niztg/Sky130-SAR-ADC/documentation/sar_adc_design.pdf

# 10-bit SAR ADC Design in Sky130 – Project Report

## Contents

1 Introduction and Specifications | 3
2 Architecture Overview | 4
3 Block Design and Sizing | 5
4 Integration & Debugging | 15
5 Static Performance Characterisation | 20

6 Discussion | 23
7 Conclusions | 25
References | 25
A Source Code and Reproducibility | 26

## 1 Introduction and Specifications

The successive-approximation (SAR) ADC is one of the most widely-used and versatile analog-to-digital converter toplogies [1]. Owing to its low power consumption, low la-

tency and compact form factor, it has proven supremely versatile, with notable usage in IoT devices, medical equipment and microcontrollers. This document describes an original 10-bit SAR ADC designed and verified in the SkyWater Sky130 open-source 130nm process, a CMOS PDK developed by SkyWater Technology and Google that provides full device model access without an NDA. The design targets the specifications in Table 1 and covers the complete front-end flow: behavioral modeling from first principles, transistor-level schematic capture in xschem, ngspice simulation against Sky130 device models, and Verilog RTL synthesized to Sky130 standard cells via Yosys. Physical layout is out of scope; the project targets schematic-level verification.

Table 1: Design Specifications

Parameter | Value
Resolution | 10 bits
Sample Rate | 1 MS/s
ENOB | ≥ 9 bits
Supply Voltage, VDD | 1.8 V
Reference Voltage, Vref | 1.8 V
Input Range | 0 − 1.8 V
Process | SkyWater Sky130, 130nm

The design followed a bottom-up flow, progressing sequentially through each of the following stages:

1. First-principles sizing and yield analysis via Python behavioral model
2. Block-level schematic capture in xschem and isolation verification in ngspice
3. Verilog RTL synthesis to Sky130 standard cells via Yosys
4. Full-ADC SPICE integration and static performance characterisation

This document reports the design decisions, block-level verification, integration debugging and static characterisation of the 10-bit SAR ADC. Ultimately, the design achieves a static ENOB of 7.27 bits, falling short of its 9-bit target, attributable to a characterised top-plate feedthrough mechanism detailed in Section 4.

## 2 Architecture Overview

### 2.1 Algorithm Description

The binary code corresponding to Vin is resolved bit-by-bit from MSB to LSB. Each bit N contributes a weighted voltage Vref
2

10−N to a running trial voltage Vanalog; once all bits are settled, Vanalog =

W
1024Vref, where W is the sum of the retained bit weights. At each step, the trial bit is kept if its inclusion keeps Vanalog ≤ Vin, and discarded otherwise. The

process repeats until all 10 bits are resolved.
Using an example voltage of 1.30 V, the behavior of the algorithm can be traced through as follows:
1. Assert bit 9 of the trial code, corresponding to an analog voltage of Vanalog =
| 1
| 2 10−9 ·

Vref = 0.9 V

2. Compare Vin = 1.3 V to Vanalog; Vin > Vanalog, therefore retain bit 9, assert bit 8. New trial code: 1100000000, corresponding voltage Vanalog =
| 1
| 2 10−9 ·Vref +
| 1
| 2 10−8 ·Vref =

1.35 V

3. Compare Vin to Vanalog; Vin < Vanalog therefore reject bit 8, assert bit 7. New code = 1010000000, corresponding voltage Vanalog =
| 1
| 2 10−9 · Vref +
| 1
| 2 10−7 · Vref = 1.125 V

This process repeats until all 10 bits are individually checked, in this case resulting in the code 1011100011 = 1.299 V.

### 2.2 Operation

The design is comprised of four major blocks: the bootstrapped switch, CDAC binary-weighted array, StrongARM comparator and SAR logic block, and works in two phases: sampling and conversion. During the sampling phase, the bootstrapped switch connects Vin to all bottom plates of the CDAC array simultaneously, while the shared top plate node VDAC is reset to Vcm = Vref / 2. This establishes a charge on the CDAC of Q = (Vref/2 − Vin)· Ctotal. At the start of conversion, the bootstrapped switch is disconnected,

leaving VDAC floating while the bottom plate of each node is shorted to ground. The SAR logic then performs a binary search from the MSB downward: each trial bit steers its corresponding bottom plate to Vref, shifting VDAC upward by an amount proportional to that capacitor’s weight. At the conclusion of this search, the StrongARM comparator evaluates whether Vref/2 is greater than VDAC, equivalent to testing whether Vin exceeds the analog value of the current trial code. The SAR logic retains or clears each bit accordingly:

1. Assert trial code 1000000000; bottom plate of 512C switches to Vref, shifting VDAC upwards to 512
1024Vref.

2. If VDAC < Vref/2 (equivalently, Vin >

512
1024Vref), retain bit 9; otherwise clear it and

return that bottom plate to ground

3. Assert the next trial bit (bit 8; adding an upwards shift of 256
1024Vref to VDAC) and

repeat in descending order until all 10 bits are resolved

This process is summarized by the block diagram in figure 1.

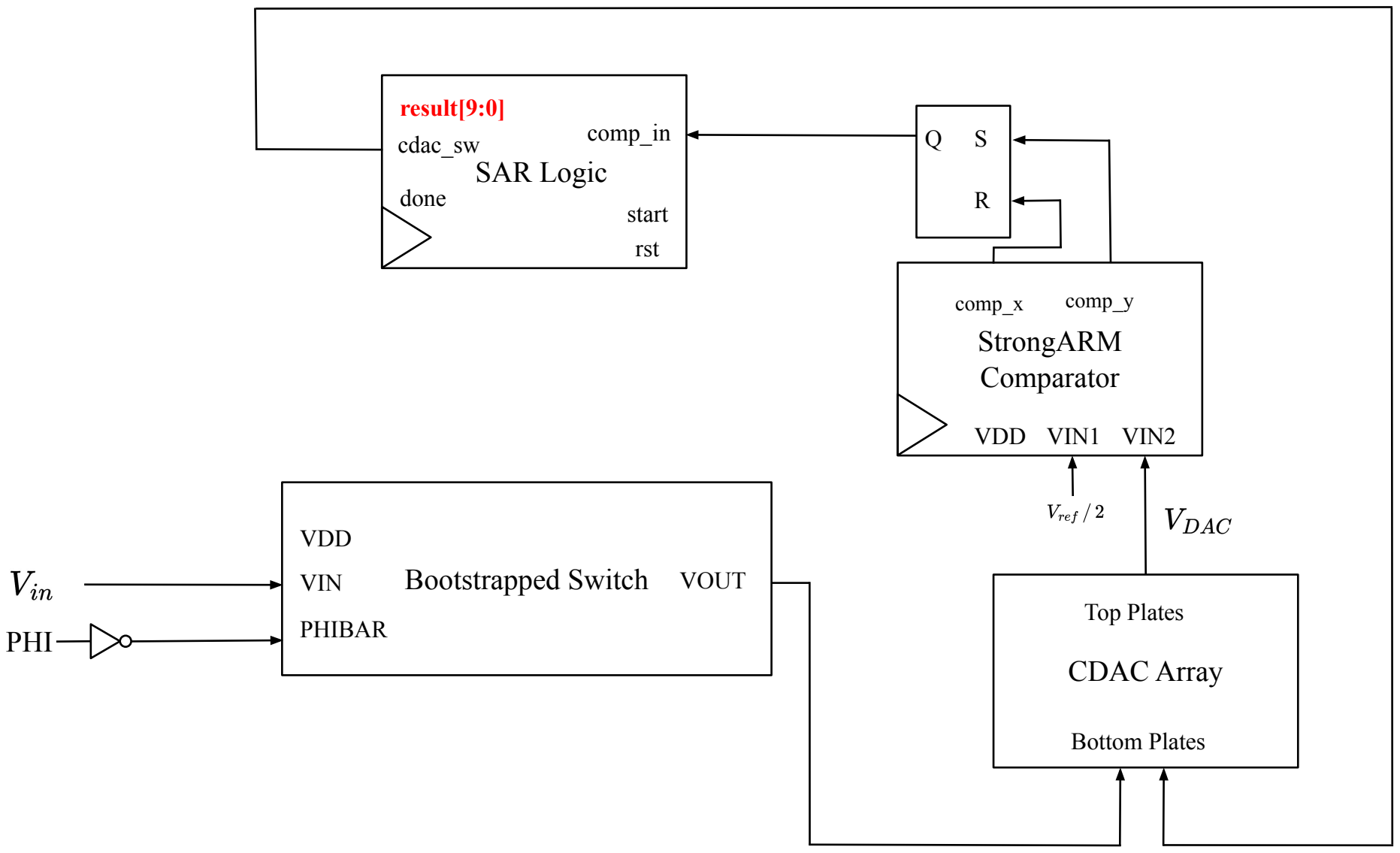
[picture p1: figure]
VIN; Bootstrapped Switch; VDD; PHIBAR; VOUT; PHI; CDAC Array; Bottom Plates; Top Plates; StrongARM Comparator; VDD VIN1 VIN2; comp_y; SAR Logic; rst; start; result[9:0]; cdac_sw; comp_x; done; comp_in

Figure 1: Block diagram of SAR ADC

## 3 Block Design and Sizing

This section covers the transistor-level design of each block in the ADC, including the bootstrapped sampling switch, the charge-redistribution DAC, the StrongARM comparator, and the SAR control logic, with particular attention to the sizing decisions that tie back to the 10-bit, 1 MS/s specifications.

### 3.1 Python Behavioral Model

The minimum valid unit capacitance, Cunit, that can be used for any capacitor in the CDAC array is set by requiring the rms kT/C sampling noise to remain below half an

LSB, giving equation 1.

Cmin =

kT
(VLSB/2)²

(1)

with VLSB =

Vref
2N , where N is the resolution of the instrument. Substituting k = 1.38 × 10⁻²³ J/K, T = 300 K, Vref = 1.8 V and N = 10, Cmin is found as 5.36 fF.

In order to determine a suitable unit capacitance, a Monte Carlo mismatch analysis was conducted. Twenty candidate values of Cunit were swept from 3 Cmin to 6 Cmin (≈ 16.1 fF to ≈ 32.2 fF), with Cmin itself as the natural lower anchor for the range, since

below it thermal noise alone exceeds the half-LSB budget regardless of mismatch. For each candidate value, 2 000 independent trials were run. In each trial, a binary-weighted capacitor array, [512, 256, 128, ..., 2, 1, 1] × Cunit, representing the CDAC array, was generated with every capacitor perturbed according to σC/C /

√
ncells, where the mismatch σC/C is 2%, and ncells = Cunit / Cmin. Using this perturbed array, the SAR conversion algorithm was executed on 2¹⁶ = 65 536 input voltages spanning the full input range (64 per binary

code), and the DNL and INL were computed from the resulting code histogram, with the maximum |INL| recorded for that trial.

The yield is computed as the fraction of trials where the maximum INL is less than 0.5 LSB. As can be seen in figure 2, the yield surpasses its target of 99% at approximately

24 fF. Therefore, to allow for some margin, a target value of Cunit = 25 fF was selected, giving a total CDAC capacitance of 1024 × 25 fF = 25.6 pF.

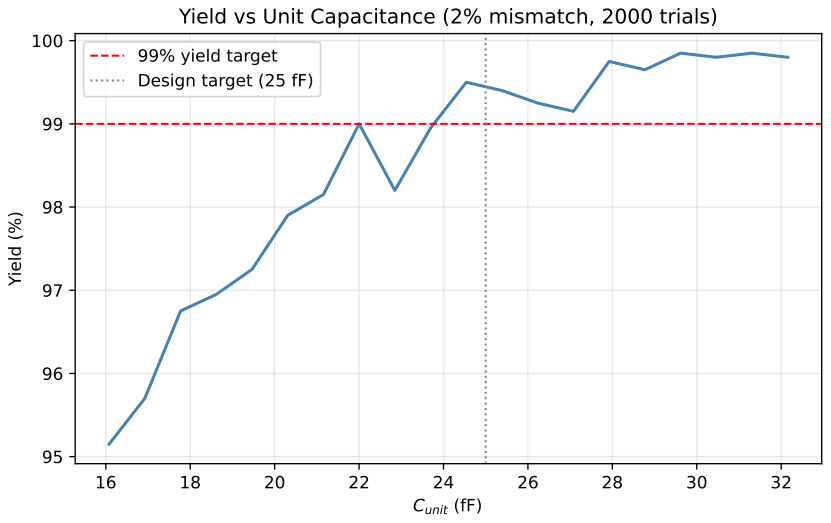
[picture p2: figure]
Cunit (fF); Yield (%); 99% yield target Design target (25 fF)

Yield vs Unit Capacitance (2% mismatch, 2000 trials)

Figure 2: Yield vs. Cunit sweep across 10 000 Monte Carlo trials at σC/C = 2%.

To validate the selected Cunit = 25 fF, a further 10 000-trial Monte Carlo simulation was run at this fixed value. Figure 3 shows the resulting distribution of maximum INL across all trials. The distribution is centred near 0.2 LSB, with a tail that barely reaches the 0.5 LSB threshold, confirming a yield of 99.2%.

0.1 | 0.2 | 0.3 | 0.4 | 0.5 | 0.6 | 0.7
Max INL (LSB)

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
Number of trials

### Max INL Distribution at Cunit = 25 fF Yield: 99.4%

0.5 LSB threshold

Figure 3: Distribution of maximum INL at Cunit = 25 fF, 10 000 Monte Carlo trials, σC/C = 2%. Yield: 99.2%.

Figure 4 shows the DNL and INL of a representative single trial at Cunit = 25 fF. The DNL remains well within ±0.5 LSB across all 1024 output codes, with no missing

codes. The INL exhibits a random-walk character, as expected from independent capacitor mismatch errors accumulating across the code range, and stays within ±0.5 LSB

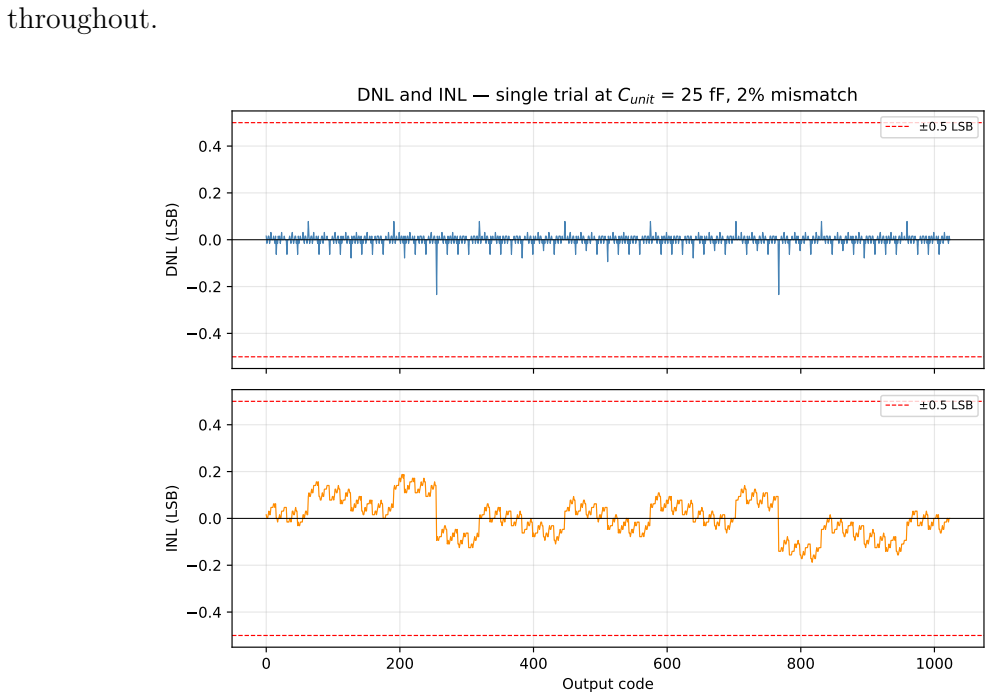
[picture p3: figure]
throughout.; DNL (LSB); ±0.5 LSB; Output code; INL (LSB)

DNL and INL single trial at Cunit = 25 fF, 2% mismatch

Figure 4: DNL and INL for a single representative trial at Cunit = 25 fF, σC/C = 2%.

### 3.2 CDAC

The CDAC is a binary-weighted array of capacitors, [512, 256, 128, ..., 2, 1, 1] × Cunit. In-

cluding the termination capacitor of capacitance Cunit, it spans 11 capacitors with a total capacitance of 1024·Cunit = 25.6 pF. The top plate of each capacitor is tied to the common

node VDAC, while each capacitor has a unique bottom plate node.
Sampling is performed on the bottom plates rather than the top plate. The top plate, VDAC, is the node the comparator reads directly; if sampling charged the top plate instead, VDAC would inherit Vin’s settling behavior and any sampling-switch nonidealities directly at the comparator input, with no capacitive division to attenuate them. Driving Vin onto the bottom plates instead means Vin only ever appears at VDAC through the capacitor network itself, and the top plate is free to be reset to a clean, fixed Vcm independent of the input. This is also why the comparator never sees Vin directly (Section 3.4): by the

time conversion starts, Vin has already been folded into the charge on the array.
During operation, the CDAC undergoes two stages:
1. Sampling: the bottom plate of each capacitor is driven to Vin, while VDAC is driven to Vcm = Vref / 2. This locks in a charge of Q = 1024 · Cunit · (Vref / 2 − Vin) onto the CDAC.
2. Conversion: VDAC is disconnected from its source and becomes floating. The SAR logic block drives the bottom plate of each capacitor to either Vref or ground, depending on whether the corresponding bit in the code under trial is high or low. For example, if the code under trial is 1010000000, then the bottom plates of C9 = 512Cunit and C7 = 128Cunit are sent to Vref, with the remaining bottom plates being shorted to ground. At the end of conversion, VDAC =

W
1024Vref + Vref / 2 − Vin. Note that

during conversion, the bottom plate of the termination capacitor is always shorted to ground.

For each analog voltage under test, sampling occurs once at the start of the procedure, while conversion happens once per bit, progressing from the MSB to the LSB. The transistor-level logic that controls the CDAC’s behavior is shown in figure 5.

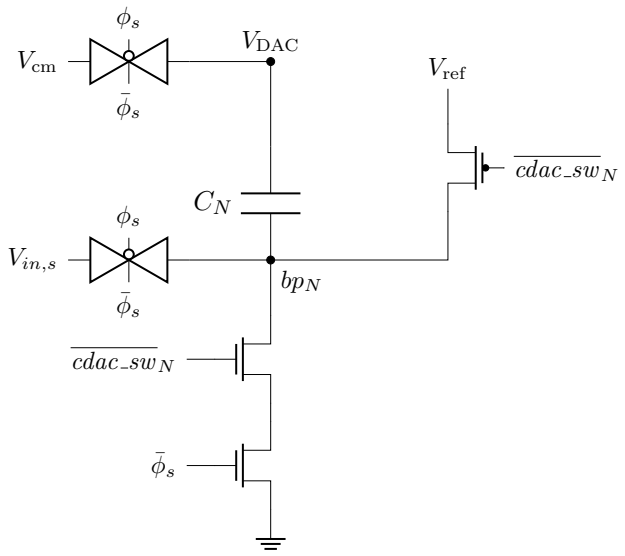
[picture p4: figure]
Vcm; VDAC; bpN; Vref; cdac sw N; Vin,s

Figure 5: Transistor-level design of one CDAC cell

The diagram in figure 5 applies to all capacitors in the CDAC except for the termination capacitor. Note that for compactness, the transmission gate responsible for charging VDAC to Vcm during sampling is included in figure 5; however, because VDAC is shared by all capacitors, the entire CDAC only uses one such transmission gate rather than one per cell. The signal cdac swN represents the high/low value of Nth bit in the trial code. The

capacitor CN is responsible for the voltage contribution of this bit to VDAC, and has a capacitance value of CN = 2N · Cunit.

During sampling, ϕs is high, meaning that both transmission gates are active and VDAC gets sent to Vcm while each VbpN

is sent to Vin. Thereafter, ϕs turns off and both transmission gates are switched off, leaving VDAC floating and initiating the conversion stage. If cdac swN is high, then its complement cdac sw N is low and the PMOS of the pull-up network turns on, shorting bpN to Vref. Otherwise, the top NMOS in the pull-down network is activated and bpN is routed to ground. The additional NMOS gated by ϕ¯
s in the pull-down network is introduced due to contention; if it were not there, then the pull-down network would provide a path to ground during sampling while cdac swN is low. Since ϕs is guaranteed to be high during sampling and low during conversion, this NMOS ensures that the pull-down network is never active during sampling but can still be active during conversion.
Note that due to its repetitive nature, no schematic for the CDAC array was designed by hand, with cdac.spice instead being written directly.

### 3.3 Bootstrapped Switch

### 3.3.1 Motivation

Bootstrapping is necessary in order to avoid bandwidth modulation and harmonic distortion when charging the bottom plates of the CDAC up to Vin. When an NMOS is used to charge up the CDAC, the channel resistance Ron of the FET and the capacitance of the CDAC create a low-pass filter with cutoff frequency given by equation 2.

fn =

1

2πRonCDAC

(2)

The channel resistance Ron of an NMOS is given by equation 3.

Ron =

1

µnCox

W
L

(VGS − Vth,n)

(3)

If the FET is gated by VDD, then VGS = VDD − Vin, meaning that if Vin changes, the

bandwidth of the low-pass filter varies, attenuating signals inconsistently. This unevenness results in harmonic distortion, lowering the effective resolution of the instrument. The bootstrapped switch [2] combats this by lifting the gate voltage of the FET to VDD + Vin,

therefore fixing VGS at VDD, thus fixing Ron and the corresponding cutoff frequency of the transfer function.

### 3.3.2 Topology and Operation

The topology of the bootstrapped switch is shown in figure 6. It operates in two stages.

1. When ϕs is low, the PMOS Q2 is off while the NMOS Q5 is on, therefore wiring the node X to ground. As such, the NMOS transistors Q4 and Q0 are off, while the PMOS Q1 and the NMOS Q3 are on. Therefore, there is a direct pathway from VDD to ground through Cboot, which charges up to VDD.
2. When ϕs turns on, transistors Q3 and Q5 turn off while transistor Q2 turns on, connecting node X to the precharged top plate of Cboot and beginning to pull VX upward from ground. As VX rises, Q4, whose gate is tied to X, turns on and connects the bottom plate of Cboot to Vin; since Q3’s turn-off has already isolated that bottom plate from ground, the capacitor’s precharged VDD is preserved across it and now rides on top of Vin, settling VX at VDD + Vin. The same rise in VX turns Q1 off, disconnecting Cboot’s top plate from the VDD rail so the boosted voltage is not clamped, and turns Q0 on, providing a pathway for Vin to flow into Vin,s with its gate held at VX.

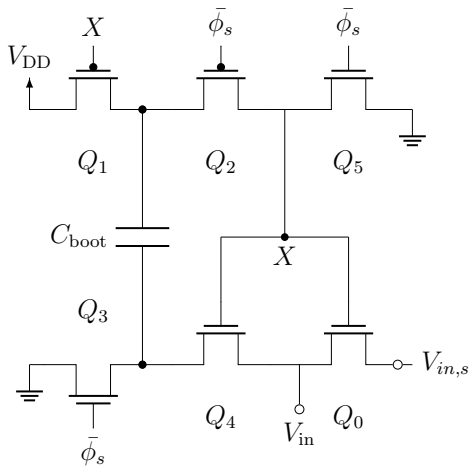
[picture p5: figure]
Vin,s; Vin; VDD; Cboot

Figure 6: Bootstrapped sampling switch. Q0 is the main sampling device; Cboot is precharged to VDD during ϕ¯
s and bootstraps the gate of Q0 to Vin + VDD during ϕs.

### 3.3.3 Parameter Derivations

Together with the CDAC, the bootstrapped switch enforces the three-phase behavior of the signal ϕs. During phase 1, ϕs must be low so as to allow Cboot to charge. Then, ϕs must become high to turn the switch on and charge up the CDAC. Finally, ϕs permanently turns off, disconnecting the CDAC from the bootstrapped switch which has accomplished its purpose by fixing charge onto the CDAC.
In totality, this means that ϕs must be a pulse that starts after a delay. The length of this pulse determines the sizing of the transistors and the value of Cboot. This length, in turn, is determined by the sample rate design target, 1 megasample per second.
A rate of 1 megasample per second implies a period of 1 µs. Using a typical 70-30 split,

with 30% of the period allotted to sampling, the width of the pulse is 300 ns. During the width of this pulse, the CDAC must be charged sufficiently to avoid a rounding error. Practically, this means that the error of the CDAC’s voltage must be less than half of an LSB. The error of the CDAC’s voltage, defined as the difference between Vin and VDAC, is given by equation 4.

Error = Vin · e

−t / RonCDAC | (4)

Requiring this error to be less than the value of half of one LSB, Error <

Vref
2N+1 , and
assuming a worst-case scenario of Vin = Vref, an expression for Ron can be derived.

Ron ≤

t
CDAC · (N + 1) · ln 2 | (5)

Substituting t = 300 ns, CDAC = 25.6 pF and N = 10 into equation 5, Ron is found as 1.54 kΩ. Applying the channel resistance equation of equation 3, with VGS = VDD = 1.8 V due to bootstrapping, µnCox = 270 µA
V² and Vth,n = 0.48 V as set by Sky130, and l = 150 nm (the minimum allowable channel length in Sky130), the minimum value for w is found as 273.8 nm. Allowing for an ample margin, the transistor Q0 was chosen to have a width of 1 µm. Auxiliary transistors Q1 and Q3−5 were sized to match Q0’s width for

layout convenience, while Q2 was sized conservatively with a width double that of Q0. All transistors have an identical length of 150 nm.
Using these design parameters, a value of Cboot was selected that sufficiently minimizes droop. The voltage droop on Cboot due to charge sharing with the parasitic gate capacitance of Q0, Cgate, is given by equation 6.

∆V

VDD

=

Cgate

Cgate + Cboot

(6)

Setting this quantity to be strictly less than 0.01,

Cgate

Cgate + Cboot

< 0.01

100 · Cgate < Cboot + Cgate

Cboot > 99 · Cgate | (7)

The gate capacitance, Cgate, is given by Cgate = wl · Cox. Substituting w = 1 µm,

l = 150 nm and Cox = 17 fF
µm² as set by Sky130, Cboot > 252.45 fF. To significantly exceed this mark, Cboot was chosen as 500 fF. The final design choices are summarized in table 2.

Table 2: Sizing Choices

Parameter | Value
Width of Q0 | 1 µm
Channel length of Q0 | 150 nm
Cboot | 500 fF

### 3.4 StrongARM Comparator

The StrongARM comparator is the block which performs the bitwise retain or reject decision making for each trial code. Its topology is shown in figure 7.

VDD

CLK | M7
Vin1 | M1 | M2 | Vin2
| P | Q
M3 | M4
M5 | M6
X | Y
S3 | S4

CLK

S1

CLK

S2

Figure 7: StrongARM latch comparator (Figure 1(b) from Razavi [3]). M1–M2 form the input differential pair, M3–M4 the cross-coupled NMOS latch, M5–M6 the cross-coupled PMOS latch, M7 the tail switch, and S1–S4 the precharge switches. Nodes P and Q are the intermediate amplification nodes; X and Y are the differential outputs.

When the clock is low, the pull-up network is active and the nodes P, Q, X and Y are pulled up to VDD. When the clock turns on, the pull-up network is disabled while the NMOS pull-down network comprised of M1, M2 and M7 is enabled, offering a pathway for the voltages at P and Q to discharge to ground. If Vin1 exceeds Vin2, the gate-source voltage and hence the rate of discharge at P is greater than that of Q, and if the reverse is true (Vin2 > Vin1), then Q discharges faster than P. Suppose that Vin1 > Vin2. Then,

P discharges faster than Q, meaning that the NMOS M3 turns on before M4, offering a discharge pathway to ground for the voltage at X. Due to the cross-coupling between M3, M4, M5 and M6, X decreasing means that the gate voltage at M4 decreases, slowing the rate of discharge at Y. Eventually, VX is low enough to enable M6 while disabling M4, hence pulling Y up to VDD. Therefore, if Vin1 > Vin2, VY settles at VDD at steady state, while VX settles at 0. Following identical logic, in the reverse case where Vin2 > Vin1, VY settles at 0 while VX settles at VDD.
During operation, Vin1 = Vref / 2 while Vin2 = VDAC. As noted in subsection 3.2,

VDAC =

W
1024Vref + Vref / 2 − Vin at the end of conversion. The condition for Y to be high

is:

Vin1 > Vin2

Vref / 2 > VDAC

Vref / 2 >

W
1024

Vref + Vref / 2 − Vin

0 >

W
1024

Vref − Vin

Vin >

W
1024
Vref | (8)

Therefore, when Y is high, the trial bit is asserted according to the SAR logic of section 2. X and Y will always be complementary. The comparator outputs X and Y are fed to the R and S inputs respectively of an SR latch. The Q output of the latch, which tracks Y, is fed into the SAR logic block.

### 3.5 SAR Logic

### 3.5.1 Operation

When start is asserted, signalling the start of a new conversion, the SAR logic clears its result and cdac sw registers, resets the bit index to 9, raises the internal active flag, and asserts cdac sw[9], steering the MSB capacitor to Vref.
On each subsequent rising clock edge, the logic reads comp in, which tracks the SR latch output Q, and records the decision in result[bit idx]. The current trial bit in cdac sw is kept if comp in is high, or cleared if low. The next bit is then asserted in cdac sw, updating VDAC for the following comparison as seen in figure 5, and the bit index is decremented. This continues until bit 0 is evaluated, at which point done is asserted, active is cleared, and the block idles until the next start pulse.

### 3.5.2 Implementation

The SAR logic was written in Verilog RTL and verified behaviorally using Icarus Verilog. It was then synthesised to Sky130 high-density standard cells using Yosys, producing a gate-level SPICE netlist via Yosys’s write spice command.
The Yosys-generated netlist required post-processing before it could be used in simulation. Yosys omits power pins (VDD/GND) from standard cell instantiations, and in some cases emits zero-volt voltage sources as net aliases rather than explicit connections. A Python script, fix spice ports.py, was written to correct both issues: it parses the Sky130 PDK SPICE library directly to recover the correct port order for each standard cell, inserts the missing power pins, resolves net aliases, and wraps the result in a .subckt block. The output, sar logic fixed.spice, is the netlist used in all subsequent simulations.

## 4 Integration & Debugging

With all four blocks verified in isolation (Section 3), the remaining work was to close

the loop and find why the full converter did not reproduce the trajectory the behavioral model predicted. Most of the design effort, and the most interesting findings, came from this phase rather than from any single block.

### 4.1 Full-loop testbench

The integration testbench (sar adc tb v2.spice) wires the four blocks into the conversion loop: the CDAC presents vdac to the StrongARM comparator, which compares it against vcm; the comparator outputs drive a two-NAND SR latch that holds the decision as comp in; and the SAR logic consumes comp in to update the ten switch controls cdac sw[9:0] for the next trial. A single clock edge both captures the previous bit’s decision and advances to the next trial, so the loop needs only one clock domain.

Clocking. Each conversion is ten cycles. The testbench runs the clock at 500 kHz (2 µs per cycle, 20 µs per conversion), deliberately relaxed from the 1 MS/s target rate so that

vdac settles fully on every trial and any error is attributable to the circuit rather than to incomplete settling. Within a cycle, the cdac sw update is followed by ∼990 ns of settling before clkbar goes high and the comparator evaluates, leaving ∼1010 ns for the

comparator and SR latch to resolve before the next rising clock edge reads comp in. This relaxed rate was a debugging choice rather than a fundamental limitation: the perblock timing budgets in Section 3, most directly the bootstrapped switch’s Ron sizing against a 300 ns sampling window (Section 3.3), were each derived against the full 1 MS/s target. Closed-loop verification of the integrated converter at the full 1 MS/s rate was not

performed in this work and is identified as follow-on verification alongside the dynamic ENOB characterisation noted in Section 6.

Cold-start initial conditions. The single most consequential testbench fix was forcing cold-start conditions with .ic and the UIC flag on .tran. Without them, ngspice solves a DC operating point at t = 0 with phi s already mid-cycle, which produces a non-physical startup transient on vdac: it overshoots to ∼1.32 V (roughly 400 mV above its 0.9 V reset target) and takes hundreds of nanoseconds to settle, corrupting the early trials. The same

artifact appeared in two earlier block-pair testbenches before its origin was understood, and it masked the real circuit behavior across several sessions. The fix initialises vdac to its reset value (Vcm = 0.9 V) and every CDAC bottom plate plus the sampled-input node

to Vin, matching the state the sample phase will drive them to anyway.

Done-verified readout. Rather than assuming done asserts at a fixed time and reading the result there, the testbench measures the actual assertion time with .meas ... WHEN and reads result[9:0] at 23 µs, with generous margin past the ∼20.5 µs expected

assertion. The measured assertion time then serves as a sanity check that the read margin was in fact adequate. Every cdac sw bit and comp in are also probed at full resolution so the bit-by-bit decision sequence can be checked against the precomputed ideal trajectory.

### 4.2 Isolation-first debugging methodology

The first full-loop run at Vin = 1.2 V returned a code roughly 77 LSB below the expected value, an error which could not be attributed to rounding. Rather than debug the closed loop directly, where any of four blocks could be at fault, each block and then each pairwise combination was re-verified in isolation:

- Switch alone — sampling accuracy versus input voltage.
- Comparator alone — ∼350 µV input kickback, which is expected for a Stron-

gARM topology and benign at this signal level.

- CDAC alone — bottom-plate sampling and convert-phase switching.
- CDAC + comparator chain — the analog half of the loop with no SAR logic in

the path.

This narrowed the error to the sampling switch at high input voltages: the comparator, CDAC, and digital logic were each correct, and the error scaled with Vin in a way that pointed at the front-end switch.

### 4.3 The n-well bootstrap bug

This was the most original finding and the one that took the most work to pin down.

Symptom. The bootstrapped switch undersampled by ∼89 mV at Vin = 1.5 V, with

negligible error at Vin = 1.2 V, a strongly input-dependent loss that grew toward the top of the input range.

Wrong hypothesis first. The initial theory was a channel turn-off race on XQ1, the PFET that precharges the boost capacitor’s top plate. Because XQ1’s gate is the very node it is trying to stop charging, an incomplete self-turn-off is a plausible characteristic of this topology. A standalone leakage testbench with a current-sense source in series with XQ1’s drain measured a real ∼0.2 mA transient at the boost transition, which appeared

to confirm the hypothesis.

Falsified by charge balance. The hypothesis did not survive a charge-balance check. Integrating that drain current over its conduction window accounts for only ∼1 fC, whereas the charge actually missing from the boost capacitor was ∼394 fC. The measured channel current was real but roughly 400× too small to be the dominant mechanism. Chasing

that two-order-of-magnitude gap, rather than accepting a plausible-looking number, is what found the actual bug.

Root cause: forward-biased PMOS body diode. XQ1 and XQ2 had their bulk pins tied to fixed VDD, the correct default for ordinary PMOS, but wrong here because these two devices’ own source/drain nodes (referred to in the SPICE as net1, also known as X, and net3) are deliberately boosted above VDD during the sample phase. Once a boosted node exceeds VDD by more than a diode drop (∼0.7 V), the source/drain-to-bulk junction

stops being reverse biased and conducts as a forward diode, not a small leak but a hard voltage clamp. The signature is unmistakable: net3 settles at ∼2.50 V, almost exactly VDD plus one diode drop. Adding current-sense sources on the bulk pins themselves, a path the drain-side sense source could not see, since bulk connects straight to the VDD rail externally, measured ∼382 fC/cycle at Vin = 1.5 V, accounting for ∼97% of the deficit.

The numbers are self-consistent. The boost node should reach Vin + VDD = 3.3 V at Vin = 1.5 V but clamps at 2.5 V, a 0.8 V shortfall. On the 500 fF boost capacitor that corresponds to 0.8 V×500 fF = 400 fC of charge that never makes it onto the node, within

measurement error of the 394 fC found missing.

Fix. A new nwell switch (figure 9) subcircuit generates a floating bias node that always

tracks whichever is higher, VDD or net1: VDD during precharge, net1 during boost. The bulk pins of XQ1 and XQ2 route through this node instead of fixed VDD, so the junction never forward-biases. The subcircuit’s own two internal devices have their bulks tied to its output node, so the fix does not reintroduce the same problem on itself.

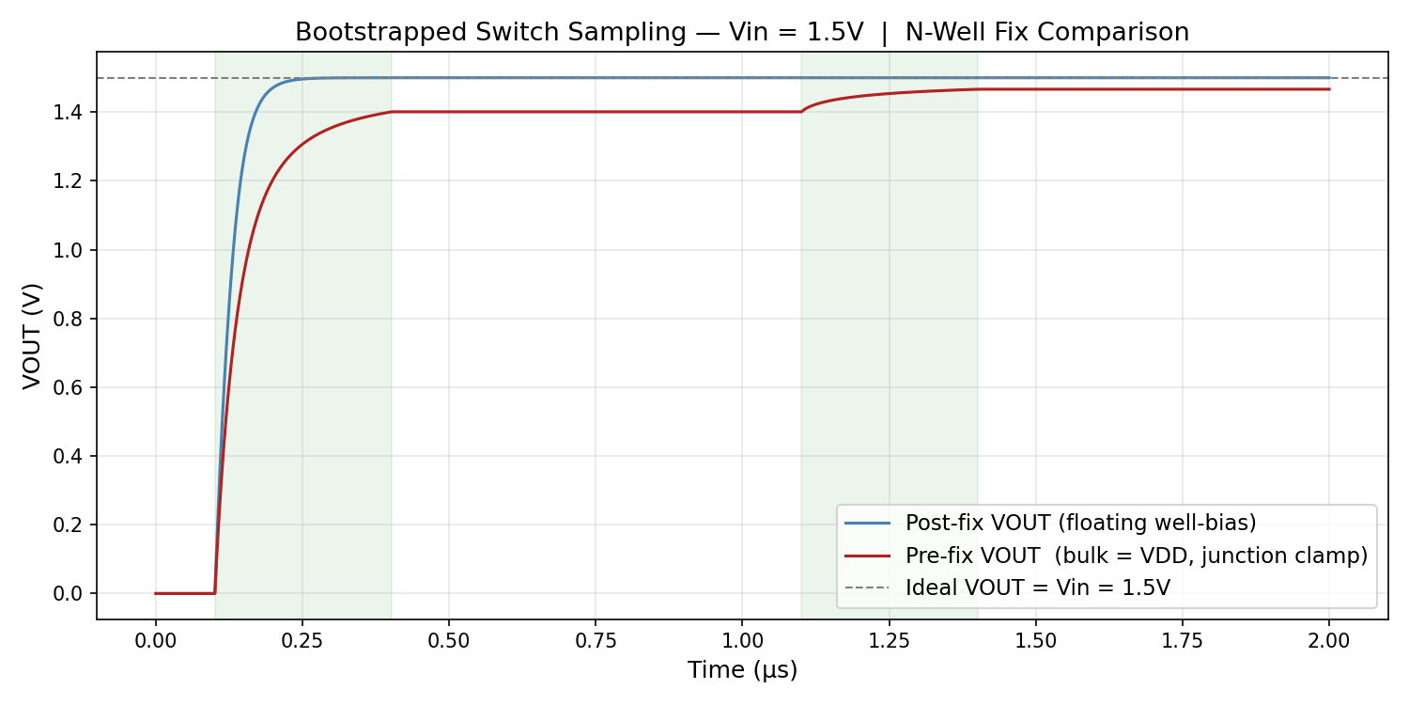
[picture p6: figure]

Figure 8: Bootstrapped switch output at Vin = 1.5 V before and after the n-well fix. Prefix (red): the forward-biased body diode clamps the boost node, limiting VOUT to ≈ 1.40 V with a ∼450 ns settling tail into the second sample window. Post-fix (blue): VOUT reaches Vin within the first sample window. Shaded regions indicate the sampling phase.

Result. In the isolated switch testbench the sampling error dropped from ∼89 mV to 0.94 µV (figure 8), and the bulk-junction current collapsed from −382 fC to +0.15 fC per

cycle. Re-running the full ADC gave −6, −11, and −54 LSB at Vin = 0.6, 1.2, and 1.5 V

respectively; the dominant front-end loss removed, leaving a smaller residual at high input that is the subject of the next subsection.

X

net3

VDD

(a)

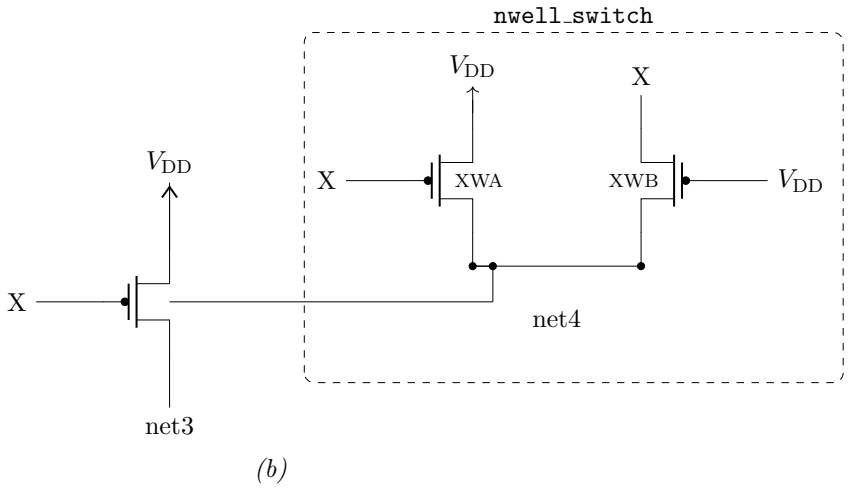
[picture p7: figure]
VDD; net3; XWA; XWB; net4; nwell switch

Figure 9: Bulk connection for the bootstrapped-switch PMOS XQ1. (a) Original design: bulk tied to the fixed VDD rail. During the hold phase X and net3 boost above VDD; the source/bulk p-n junction forward-biases and bleeds charge into the supply rail, clamping net3 to ≈ 2.5 V and collapsing the bootstrap voltage. (b) Fix: bulk re-routed to the floating nwell switch bias node (net4). XXWA and XXWB are cross-coupled PMOS source-followers that drive net4 to max(VDD, X), maintaining reverse bias on the junction throughout the clock cycle. An identical fix is applied to the bulk of XQ2.

### 4.4 Residual error: top-plate reset feedthrough

The −54 LSB at Vin = 1.5 V that remains after the bootstrap fix is a separate mechanism. At the sample-to-convert transition, the top-plate reset switch XTOP n couples charge onto vdac through its gate-drain overlap capacitance, kicking the node away from its reset value just as the conversion begins.
Isolated testbenches characterised the kick as a function of input voltage:

Table 3: Residual error on VDAC as a function of input voltage

Vin (V) | Kick on vdac
0.3 | ∼0.6 mV
0.6 | ∼4.8 mV
0.9 | ∼9 mV
1.2 | ∼15 mV
1.5 | ∼122–160 mV (with a ∼450–500 ns settling tail)

The kick grows nonlinearly with Vin and develops a long settling tail near the top of the range. Because the error is strongly input-dependent rather than a fixed offset, it cannot be removed by a single static digital calibration constant. Known mitigations (a

dummy top-plate switch for charge cancellation, or a separate reset phase that lets vdac settle before the comparator looks at it) were identified but not implemented, since the

converter already meets its functional goals and physical layout is the next priority rather than squeezing the last few LSB of high-input linearity.

## 5 Static Performance Characterisation

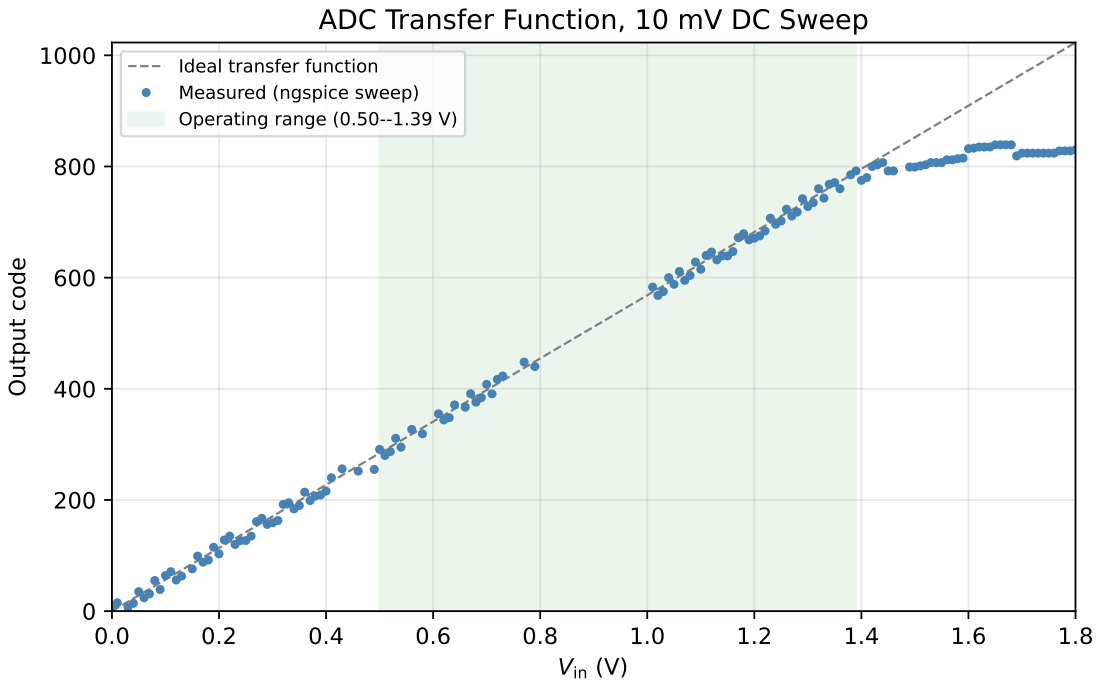
[picture p8: figure]
Vin (V); Output code; ADC Transfer Function, 10 mV DC Sweep; Ideal transfer function; Measured (ngspice sweep); Operating range

Figure 10: Measured ADC transfer function: output code vs. Vin from the ngspice DC sweep (141 points), against the ideal straight-line characteristic. The shaded region marks the auto-detected operating range.

### 5.1 DC Sweep Methodology

Static linearity was characterised by sweeping a DC input voltage from 0 to 1.8 V and recording the 10-bit output code at each point. The sweep was implemented in sweep adc.py, which spawns a separate ngspice process per input voltage rather than running a monolithic multi-point simulation, which would have exhausted ngspice’s internal memory. Input voltages were stepped in 10 mV increments, giving a theoretical 181 points over 0–1.8 V. Of these, 141 points returned valid done-asserted conversions, with the other 40 failing to complete before the self-imposed 180-second time limit. The operating range was auto-detected as 0.50–1.39 V by find operating range.py, which identifies the contiguous span of codes whose conversion error stays within ±35 mV of the ideal; points outside this range reflect the bootstrapped switch failing to fully charge the CDAC at low input voltages, and CDAC top-plate feedthrough saturating the output at high voltages. Fig. 11 shows the full-range error plot used for this detection.

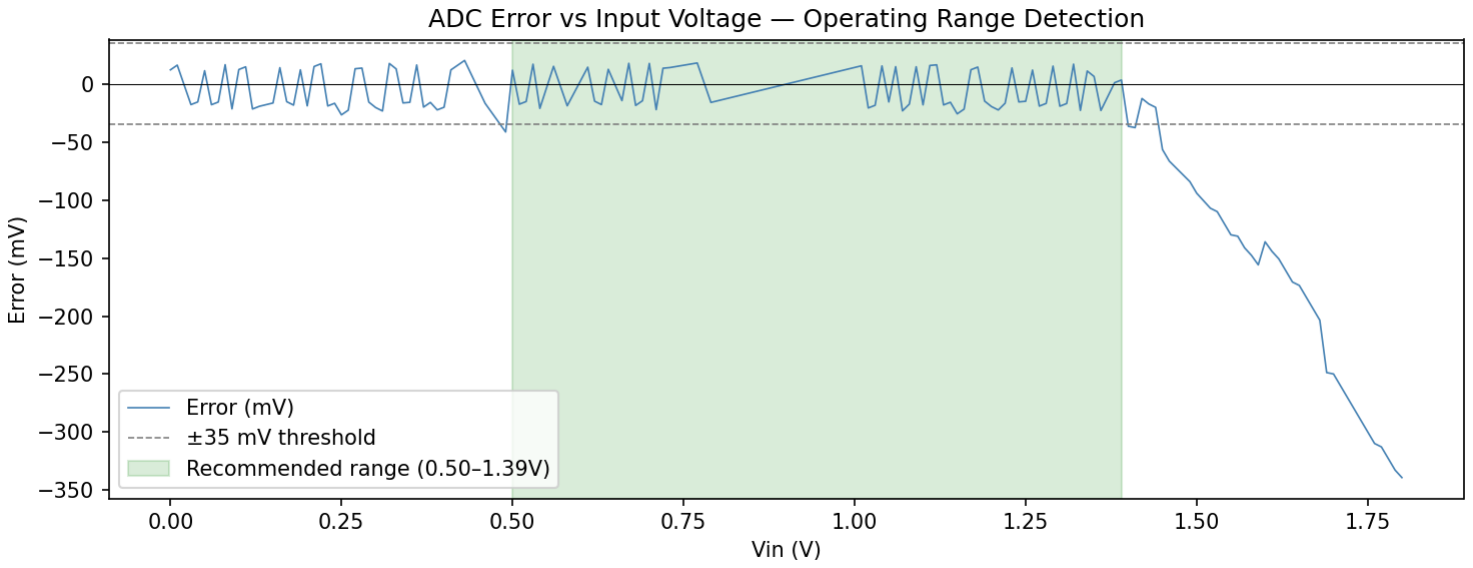
[picture p9: figure]

Figure 11: ADC conversion error over 0–1.8 V. The shaded region (0.50–1.39 V) is the auto-detected operating range, bounded by a ±35 mV threshold. The monotone ramp below 0.5 V reflects bootstrapped switch underdriving; the steep negative error above 1.39 V is top-plate feedthrough from XTOP n growing nonlinearly as Vin approaches VDD.

### 5.2 INL Results

INL was computed by fitting a best-fit line to the transfer function over the valid operating range and measuring the deviation of each code transition from the ideal. The raw and smoothed INL curves are shown in Fig. 12.

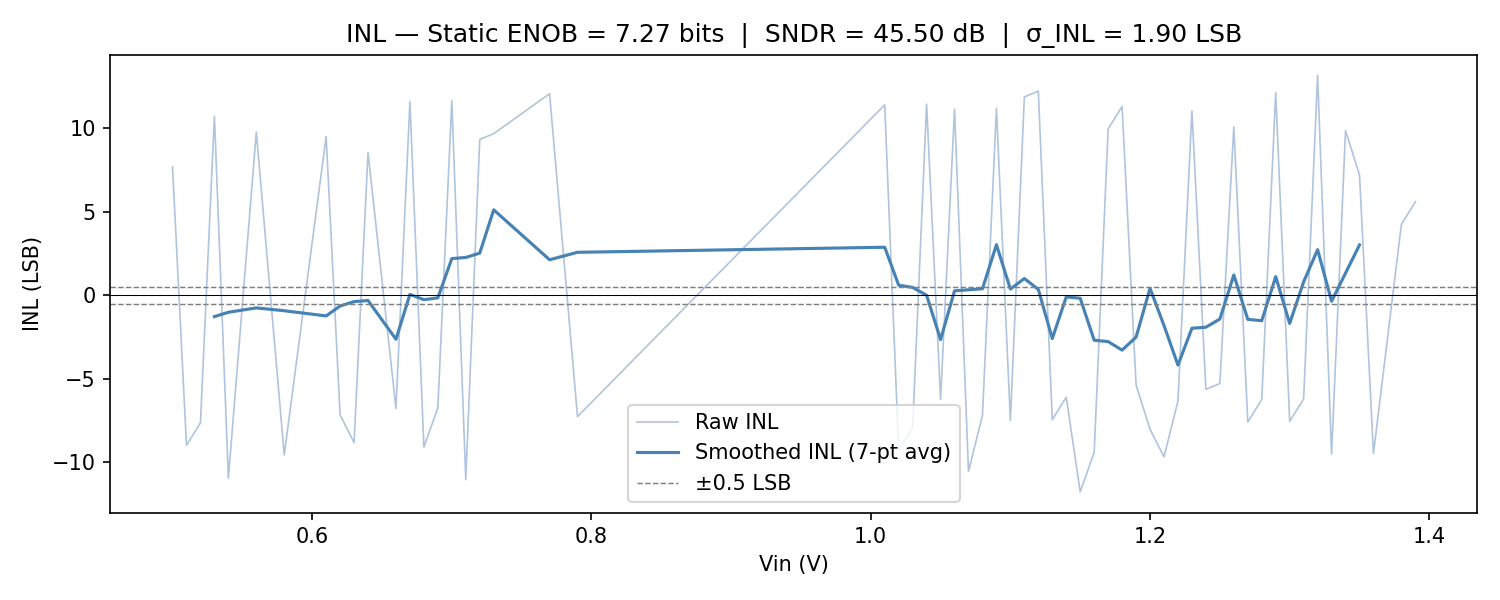
[picture p10: figure]

Figure 12: Raw and smoothed INL over the valid input range (0.50–1.39 V). The diagonal line visible in the raw curve near 0.79–1.01 V is an interpolation artefact caused by missing simulation points in that window, not a real feature of the transfer function. The +5 LSB peak in the smoothed curve near 0.75 V is caused by top-plate reset feedthrough from XTOP n, discussed further in Section 6.

The raw INL has a peak of ±13 LSB and an RMS of 9.21 LSB. The dominant contri-

bution to this figure is a measurement grid artefact: a 10 mV step corresponds to approximately 5.6 output codes at 10-bit resolution over 0.89 V of valid range, so the transfer function is sampled far below Nyquist for code-level detail. Each transition between grid points is assigned to the nearest sampled code, introducing a staircase quantisation error that manifests as high-frequency oscillation in the INL curve and inflates the RMS well beyond the true device nonlinearity. Applying a 7-point moving average suppresses this artefact and gives a smoothed INL of ±5 LSB peak and 1.90 LSB RMS.

### 5.3 Static ENOB

A static ENOB figure was derived from the INL by treating INL error as noise. The signal power of a full-scale sinusoid over a 10-bit ADC is (2¹⁰)

2/8 in units of LSB²
; the noise
power is taken as σ

2
INL + 1/12, where the 1/12 term accounts for ideal quantisation noise.

Using the smoothed INL RMS of 1.90 LSB:

SNDR = 10 log10

(2¹⁰)

2/8
σ

2

INL + 1/12
= 45.50 dB | (9)

ENOB = SNDR − 1.76
6.02
= 7.27 bits | (10)

These results are summarised in the title bar of Fig. 12. This falls short of the 9-bit target.
This static figure should be read in both directions rather than taken at face value. On one hand it is a lower bound on the converter’s true dynamic performance, since a DC sweep cannot capture sampling jitter or input bandwidth limitations, both of which would only erode ENOB further under a real time-varying signal. On the other hand it is simultaneously an upper bound, for the opposite reason: the dominant error source in this measurement, the top-plate feedthrough kick above roughly 1.3 V (Section 4.4), which contributes the ±13 LSB raw peak, is itself an artifact of how a DC sweep is taken.

Each point in the sweep is a separate sample-and-convert cycle, so every point pays the kick once; a genuine sine-wave input sampled at 1 MS/s would not necessarily revisit

the same high-voltage codes with the same per-cycle penalty, and the kick’s settling tail would interact with the actual sampling instants rather than with an artificially quiescent DC level. The 7.27-bit figure is therefore neither a guaranteed floor nor ceiling on dynamic performance; it reflects a specific, identified error mechanism evaluated under a measurement methodology that this mechanism is somewhat pessimistic to. A sine-wave FFT test would resolve this ambiguity directly and has not yet been performed due to processing power constraints.
A static ENOB figure was derived from the INL by treating INL error as noise. The signal power of a full-scale sinusoid over a 10-bit ADC is (2¹⁰)
2/8 in units of LSB² | ; the

noise power is taken as σ

2
INL + 1/12, where the 1/12 term accounts for ideal quantisation

noise. Using the smoothed INL RMS of 1.90 LSB:

SNDR = 10 log10

(2¹⁰)

2/8
σ

2

INL + 1/12
= 45.50 dB | (11)

ENOB = SNDR − 1.76
6.02
= 7.27 bits | (12)

These results are summarised in the title bar of Fig. 12. This falls short of the 9-bit target. The static ENOB figure represents a lower bound on true dynamic performance in one respect (it does not account for sampling jitter or bandwidth), and an upper bound in another (the top-plate feedthrough kick at inputs above roughly 1.3 V, which contributes the ±13 LSB raw peak, is not present in a static DC measurement of a real signal). A sine-

wave FFT test would give a more direct ENOB figure under realistic operating conditions and has not yet been performed due to processing power constraints.

## 6 Discussion

### 6.1 Performance Against Specification

The design targeted ≥9-bit ENOB at 1 MS/s on a 1.8 V supply. The measured static

ENOB of 7.27 bits falls short by approximately 1.7 bits. The shortfall has a single identified root cause: the top-plate reset switch XTOP n injects a feedthrough kick onto the CDAC top plate at the end of the sampling phase via gate-drain overlap capacitance (CGDO = 2.449 × 10⁻¹⁰ F/m). The kick is input-dependent and grows nonlinearly as

Vin approaches VDD, reaching approximately 15 mV at Vin = 1.2 V and 122–160 mV at Vin = 1.5 V with a settling tail of 450–500 ns. Because the error magnitude is a nonlinear function of the input, it cannot be removed by static digital calibration.
The 1 MS/s sample-rate target was met at the level of individual block timing budgets (Section 3) but was not verified end-to-end: all integration and static characterisation in

this report used a relaxed 500 kHz testbench clock, chosen so that settling error could be ruled out as a source of conversion error during debugging. Running the integrated converter at the full clock rate, where comparator regeneration and SAR logic propagation must also complete within the tighter timing budget rather than just the sampling switch, is necessary before the 1 MS/s specification can be considered fully demonstrated.

### 6.2 Operating Range

The recommended input range is 0.50–1.39 V, approximately 50% of the full supply span.

The lower bound is set by bootstrapped switch headroom: as Vin approaches ground, the gate overdrive on the main switch transistor collapses and the switch can no longer fully charge the CDAC within the sampling window. The upper bound is set by the feedthrough nonlinearity described above. Specifying an inset operating range is standard practice for

SAR ADCs; the full-scale input range nominally matching the supply rails does not imply usable linearity across that entire range.

### 6.3 Mitigation Paths

Several standard techniques would reduce or eliminate the feedthrough error but were not implemented, as they fall outside the scope of this project:

- Dummy top-plate switch: A half-sized switch driven by the complement of the

reset clock can cancel the kick by injecting an equal and opposite charge. This is the most common first-order fix.

- Separate reset phase: Decoupling the top-plate reset from the sampling phase

gives the kick time to settle before conversion begins, at the cost of a more complex clocking scheme.

- Digital background calibration: The input-dependent error profile could in prin-

ciple be characterised and subtracted digitally, but the nonlinearity near VDD is large enough that this would require significant calibration range and does not address the settling tail within a 1 MS/s conversion window.

### 6.4 Physical Layout

Magic layout was considered, but not pursued. The project scope is full-custom mixed-signal design at the schematic and simulation level: behavioral modelling, transistor sizing, block-level and system-level SPICE simulation, and static characterisation. Physical implementation would be the natural next step to demonstrate a complete design-to-GDS flow, but it does not add further insight into the analog design decisions documented here.

### 6.5 Performance Against Specification

The design targeted ≥9-bit ENOB at 1 MS/s on a 1.8 V supply. The measured static

ENOB of 7.27 bits falls short by approximately 1.7 bits. The shortfall has a single identified root cause: the top-plate reset switch XTOP n injects a feedthrough kick onto the CDAC top plate at the end of the sampling phase via gate-drain overlap capacitance (CGDO = 2.449 × 10⁻¹⁰ F/m). The kick is input-dependent and grows nonlinearly as

Vin approaches VDD, reaching approximately 15 mV at Vin = 1.2 V and 122–160 mV at Vin = 1.5 V with a settling tail of 450–500 ns. Because the error magnitude is a nonlinear function of the input, it cannot be removed by static digital calibration.
Expressed in LSB (VLSB = 1.76 mV at 10-bit resolution), the kick is below 1 LSB across

most of the input range and only becomes significant near VDD: 15 mV at Vin = 1.2 V is ∼8.5 LSB, while 122–160 mV at Vin = 1.5 V is 70–91 LSB. The static ENOB figure is therefore set almost entirely by the behavior above approximately 1.3 V; restricting the operating range further or applying the mitigations in Section 6.3 would be expected to recover most of the missing 1.7 bits, since the rest of the transfer function (Section 5)

already sits close to the ideal characteristic.

## 7 Conclusions

This project demonstrated a complete mixed-signal design flow for a 10-bit 1 MS/s SAR ADC in the SkyWater Sky130 130 nm open-source PDK, from behavioral modelling in Python through transistor-level SPICE simulation and static characterisation. All four blocks (bootstrapped switch, charge-redistribution CDAC, StrongARM comparator, and SAR control logic) were designed, sized from first principles, and verified individually

before system-level integration.
The SAR logic was synthesised from a Verilog behavioral description using Yosys and integrated as a standard-cell netlist alongside the full-custom analogue blocks, demonstrating a mixed-signal methodology applicable to real tape-out flows. A non-trivial transistor-level bug, PMOS n-well forward biasing under bootstrapped gate drive, was identified and resolved through charge-balance analysis rather than empirical tuning, accounting for 97% of the observed conversion error once correctly attributed. The static

characterisation yielded 7.27-bit ENOB against a 9-bit target, with the shortfall fully explained by a characterised top-plate feedthrough mechanism.
Falling short of the 9-bit target is, on its own, less significant than how that shortfall was reached: every discrepancy between the behavioral model and the transistor-level result was traced to a specific, physically identified mechanism rather than left as an unexplained gap, and the n-well bug in particular was found by following a charge-balance inconsistency the initial hypothesis could not account for. That methodology, isolating each block, treating disagreements between simulation and prediction as leads rather than noise, and quantifying root causes before attempting fixes, is what the remainder of the design flow (synthesis, layout, and tapeout) would build on.

## References

[1] B. Murmann, “The Successive Approximation Register ADC: A Versatile Building Block for Ultra-Low-Power to Ultra-High-Speed Applications,” IEEE Communications Magazine, vol. 54, no. 4, pp. 78–83, Apr. 2016.
[2] A. M. Abo and P. R. Gray, “A 1.5-V, 10-bit, 14.3-MS/s CMOS pipeline analog-to-

digital converter,” IEEE Journal of Solid-State Circuits, vol. 34, no. 5, pp. 599–606, May 1999.

[3] B. Razavi, “The StrongARM Latch,” IEEE Solid-State Circuits Magazine, vol. 7,

no. 2, pp. 12–17, Spring 2015.

## A Source Code and Reproducibility

The complete design (Python behavioral models, SPICE netlists, Verilog source, and characterisation scripts) is available in the sky130-sar-adc GitHub repository. Table 4 lists

the principal artifacts and their role in the flow. File names reflect the current repository layout; refer to the repository README.md for the authoritative directory structure.

Table 4: Principal design and verification artifacts

File | Role
sar adc model.py | Python behavioral model: sizing, Monte Carlo yield, DNL/INL
bootstrapped switch.spice | Bootstrapped sampling switch, including the nwell switch fix
cdac.spice | Binary-weighted CDAC array and per-bit switch clusters
sar logic renamed.v | SAR control logic, Verilog RTL
sar logic tb.v | RTL testbench (Icarus Verilog)
sar logic synth.v | Yosys-synthesised gate-level netlist (Sky130 HD cells)
sar logic.spice | Yosys-generated SPICE netlist
fix spice ports.py | Power-pin and net-alias post-processing
sar logic fixed.spice | Simulation-ready SAR logic subcircuit
sar adc tb v2.spice | Full-ADC integration testbench (cold-start .ic/UIC)
sweep adc.py | Per-point DC sweep driver
find operating range.py | Operating-range auto-detection
enob.py | INL and static ENOB computation
