niztg/Sky130-SAR-ADC/text/operating_range.txt

# Recommended operating range — generated by find_operating_range.py
vin_lo = 0.50
vin_hi = 1.39
