niztg/Sky130-SAR-ADC/text/sweep_results_prefix.txt

# vin_V  code  (pre-nwell-fix bootstrapped switch)
0.0  7
0.4  216
0.7  408
0.8  446
0.9  499
1.0  576
1.1  615
1.2  671
1.3  728
1.4  792
1.5  792
1.6  799
1.7  822
1.8  801
