niztg/Sky130-SAR-ADC/text/sweep_results.txt

# vin_V  code
0.00  7
0.01  15
0.03  7
0.04  14
0.05  35
0.06  24
0.07  31
0.08  55
0.09  39
0.10  64
0.11  71
0.12  56
0.13  63
0.15  76
0.16  99
0.17  88
0.18  92
0.19  115
0.20  103
0.21  128
0.22  135
0.23  120
0.24  127
0.25  127
0.26  135
0.27  161
0.28  167
0.29  156
0.30  159
0.31  163
0.32  192
0.33  195
0.34  184
0.35  190
0.36  214
0.37  199
0.38  207
0.39  209
0.40  216
0.41  240
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
