niztg/Sky130-SAR-ADC/documentation/figures/dnl_inl_example.pdf

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

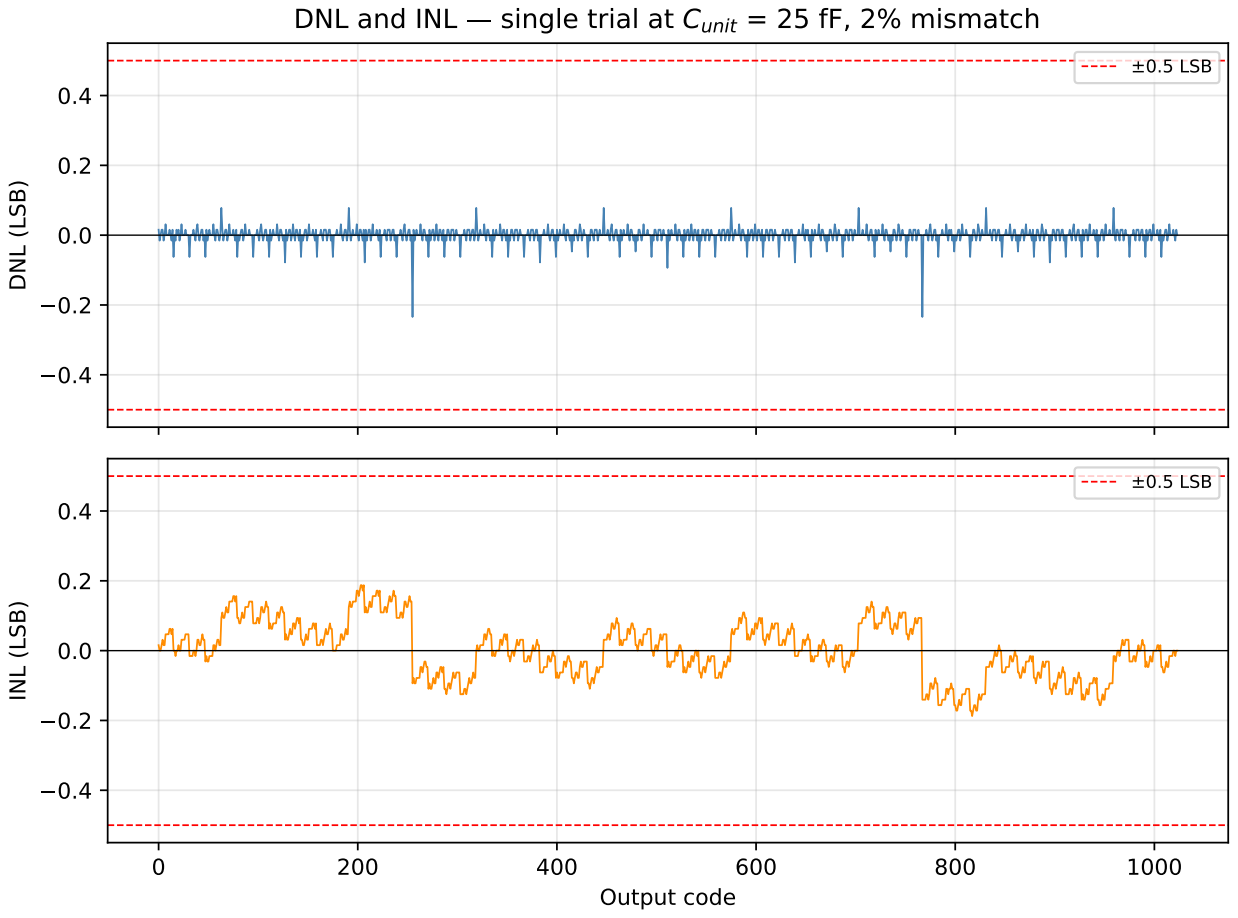
[picture p12: page 1]
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
