niztg/Sky130-SAR-ADC/testbenches/_bootstrap_tmp.spice

* Bootstrap switch — POST-FIX (floating well-bias tracks max(VDD, net1))
.subckt nwell_switch out vdd_in net1_in
Xpass_vdd out vdd_in out vdd_in sky130_fd_pr__pfet_01v8 L=0.15 W=2 nf=1 ad='int((nf+1)/2) * W/nf * 0.29' as='int((nf+2)/2) * W/nf * 0.29' pd='2*int((nf+1)/2) * (W/nf + 0.29)' ps='2*int((nf+2)/2) * (W/nf + 0.29)' nrd='0.29 / W' nrs='0.29 / W' sa=0 sb=0 sd=0 mult=1
Xpass_net1 out net1_in out out sky130_fd_pr__pfet_01v8 L=0.15 W=2 nf=1 ad='int((nf+1)/2) * W/nf * 0.29' as='int((nf+2)/2) * W/nf * 0.29' pd='2*int((nf+1)/2) * (W/nf + 0.29)' ps='2*int((nf+2)/2) * (W/nf + 0.29)' nrd='0.29 / W' nrs='0.29 / W' sa=0 sb=0 sd=0 mult=1
.ends nwell_switch

.subckt bootstrapped_switch VDD PHIBAR VOUT VIN
Xnwell_sw nwell_bias VDD net1 nwell_switch
XQ0 VIN net1 VOUT 0 sky130_fd_pr__nfet_01v8 L=0.15 W=1 nf=1 ad='int((nf+1)/2) * W/nf * 0.29' as='int((nf+2)/2) * W/nf * 0.29' pd='2*int((nf+1)/2) * (W/nf + 0.29)' ps='2*int((nf+2)/2) * (W/nf + 0.29)' nrd='0.29 / W' nrs='0.29 / W' sa=0 sb=0 sd=0 mult=1
XC_boot net3 net2 sky130_fd_pr__cap_mim_m3_1 W=15.6 L=15.6 MF=1
XQ5 net1 PHIBAR 0 0 sky130_fd_pr__nfet_01v8 L=0.15 W=1 nf=1 ad='int((nf+1)/2) * W/nf * 0.29' as='int((nf+2)/2) * W/nf * 0.29' pd='2*int((nf+1)/2) * (W/nf + 0.29)' ps='2*int((nf+2)/2) * (W/nf + 0.29)' nrd='0.29 / W' nrs='0.29 / W' sa=0 sb=0 sd=0 mult=1
XQ4 VIN net1 net2 0 sky130_fd_pr__nfet_01v8 L=0.15 W=1 nf=1 ad='int((nf+1)/2) * W/nf * 0.29' as='int((nf+2)/2) * W/nf * 0.29' pd='2*int((nf+1)/2) * (W/nf + 0.29)' ps='2*int((nf+2)/2) * (W/nf + 0.29)' nrd='0.29 / W' nrs='0.29 / W' sa=0 sb=0 sd=0 mult=1
XQ1 VDD net1 net3 nwell_bias sky130_fd_pr__pfet_01v8 L=0.15 W=2 nf=1 ad='int((nf+1)/2) * W/nf * 0.29' as='int((nf+2)/2) * W/nf * 0.29' pd='2*int((nf+1)/2) * (W/nf + 0.29)' ps='2*int((nf+2)/2) * (W/nf + 0.29)' nrd='0.29 / W' nrs='0.29 / W' sa=0 sb=0 sd=0 mult=1
XQ3 net2 PHIBAR 0 0 sky130_fd_pr__nfet_01v8 L=0.15 W=1 nf=1 ad='int((nf+1)/2) * W/nf * 0.29' as='int((nf+2)/2) * W/nf * 0.29' pd='2*int((nf+1)/2) * (W/nf + 0.29)' ps='2*int((nf+2)/2) * (W/nf + 0.29)' nrd='0.29 / W' nrs='0.29 / W' sa=0 sb=0 sd=0 mult=1
XQ2 net3 PHIBAR net1 nwell_bias sky130_fd_pr__pfet_01v8 L=0.15 W=1 nf=1 ad='int((nf+1)/2) * W/nf * 0.29' as='int((nf+2)/2) * W/nf * 0.29' pd='2*int((nf+1)/2) * (W/nf + 0.29)' ps='2*int((nf+2)/2) * (W/nf + 0.29)' nrd='0.29 / W' nrs='0.29 / W' sa=0 sb=0 sd=0 mult=1
.ends bootstrapped_switch

* Supplies and input
Vvdd VDD 0 DC 1.8
Vvin VIN 0 DC 1.5
* PHIBAR: HIGH during hold, LOW during sample
* Sample window: 100n–400n (300ns), then hold
Vphibar PHIBAR 0 PULSE(1.8 0 100n 1n 1n 300n 1000n)
* Load cap mimics CDAC total capacitance
C1 VOUT 0 25.6p

Xsw VDD PHIBAR VOUT VIN bootstrapped_switch

.lib /Users/nizansari/.volare/sky130A/libs.tech/ngspice/sky130.lib.spice tt
.tran 1n 2u UIC
.print tran v(VIN) v(VOUT) v(PHIBAR)
.end
