niztg/Sky130-SAR-ADC/(commit log)

2026-06-14 Added minimum capacitance calculation
2026-06-15 Added yield vs unit capacitance functions
2026-06-15 Added yield vs capacitance plot to determine the minimum unit capacitance that produces a yield of >99% as about 25 fF
2026-06-17 Added xschem schematics for the bootstrapped switch and StrongARM Comparator integrated circuits
    [bootstrapped_switch.sch, bootstrapped_switch_tb.sch, strongarm_comparator.sch, strongarm_comparator_tb.sch, untitled.sch]
2026-06-20 Fixed cdac and sar_adc_tb files
    [untitled.sch]
2026-06-20 Stop tracking installed tool directories
    [bootstrapped_switch.sch]
2026-06-20 Even more debugging; V_in = 0.3V and 1.2V produce a predictable 10-11 LSB of error, but V_in = 1.5V has a ton of error (~77LSB) indicating something fundamentally wrong
2026-06-20 Narrowed down error in 1.5V input test to a problem with the XQ1 switch leaking current
2026-06-21 Added nwell subcircuit which always tracks the higher of VDD or net1 (VDD+VIN), meaning that the bulk of every PMOS is always tied to the highest voltage around
2026-06-21 Changed bootstrapped switch fixed to bootstrapped switch
2026-06-21 Update README.md to reflect current state of progress and file structure
2026-06-22 Add more testbenches
    [bootstrapped_switch.sch]
2026-06-30 update README to be more current
